kwame-y/BinaryClock/Hardware/3dmodels/B3U-3000P--3DModel-STEP-56544.STEP

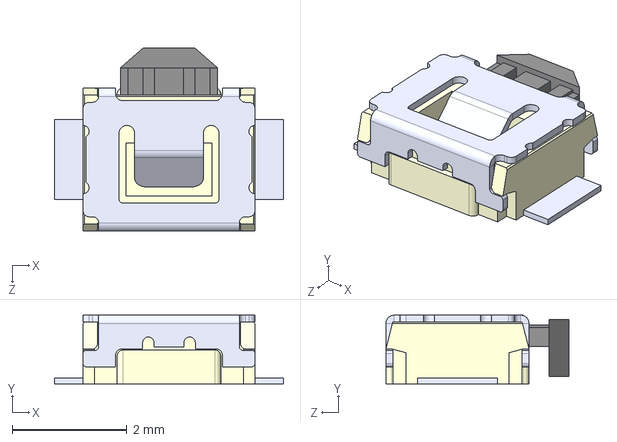
[picture p3: CAD file, 2026-10-17]
Hardware/3dmodels/B3U-3000P--3DModel-STEP-56544.STEP
4.00 x 1.20 x 3.20 mm
