kwame-y/BinaryClock/Hardware/3dmodels/IS31FL3239-QFLS4-TR.stp

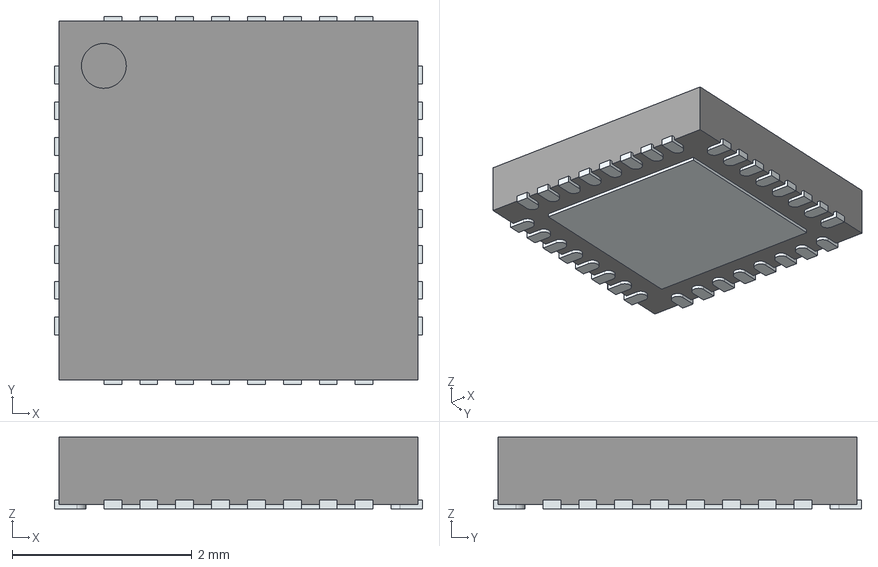
[picture p4: CAD file, 2026-10-17]
Hardware/3dmodels/IS31FL3239-QFLS4-TR.stp
4.10 x 4.10 x 0.8 mm
ThermalPin
PinsArrayLR
PinsArrayTB
