kwame-y/BinaryClock/Hardware/3dmodels/USB4105-GF-A.step

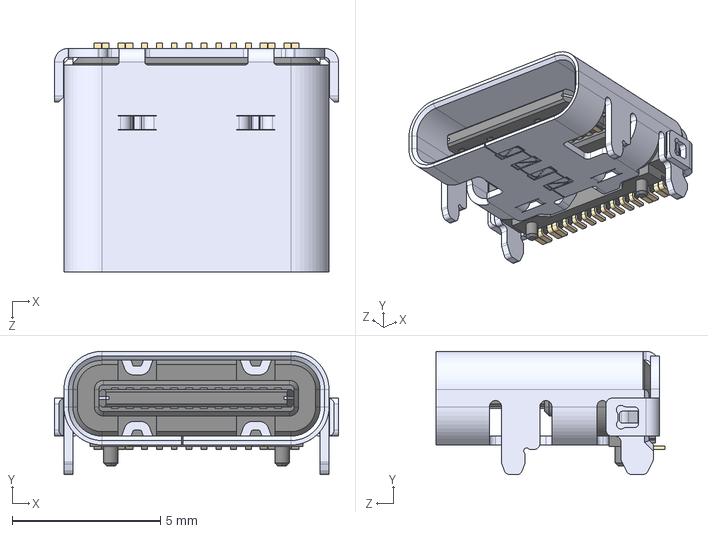
[picture p5: CAD file, 2026-10-17]
Hardware/3dmodels/USB4105-GF-A.step
9.58 x 4.16 x 7.71 mm
