kwame-y/BinaryClock/Hardware/3dmodels/APT1608.STEP

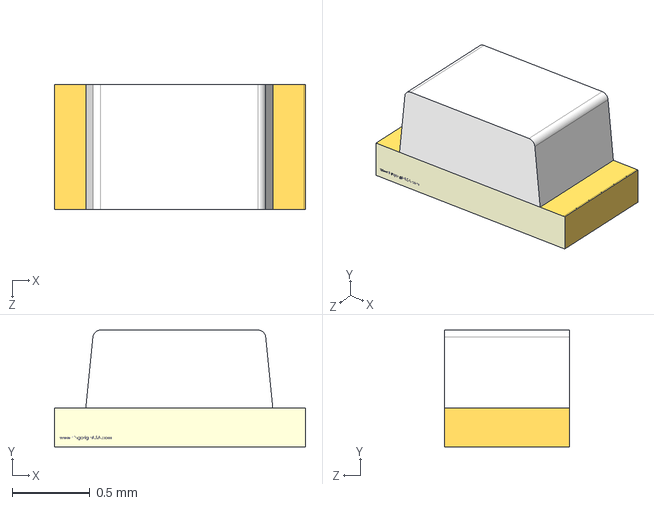
[picture p6: CAD file, 2026-10-17]
Hardware/3dmodels/APT1608.STEP
1.61 x 0.75 x 0.8 mm
