kwame-y/BinaryClock/Hardware/BinaryClock3.kicad_pcb

## KiCad design Hardware/BinaryClock3.kicad_pcb (2026-10-17)

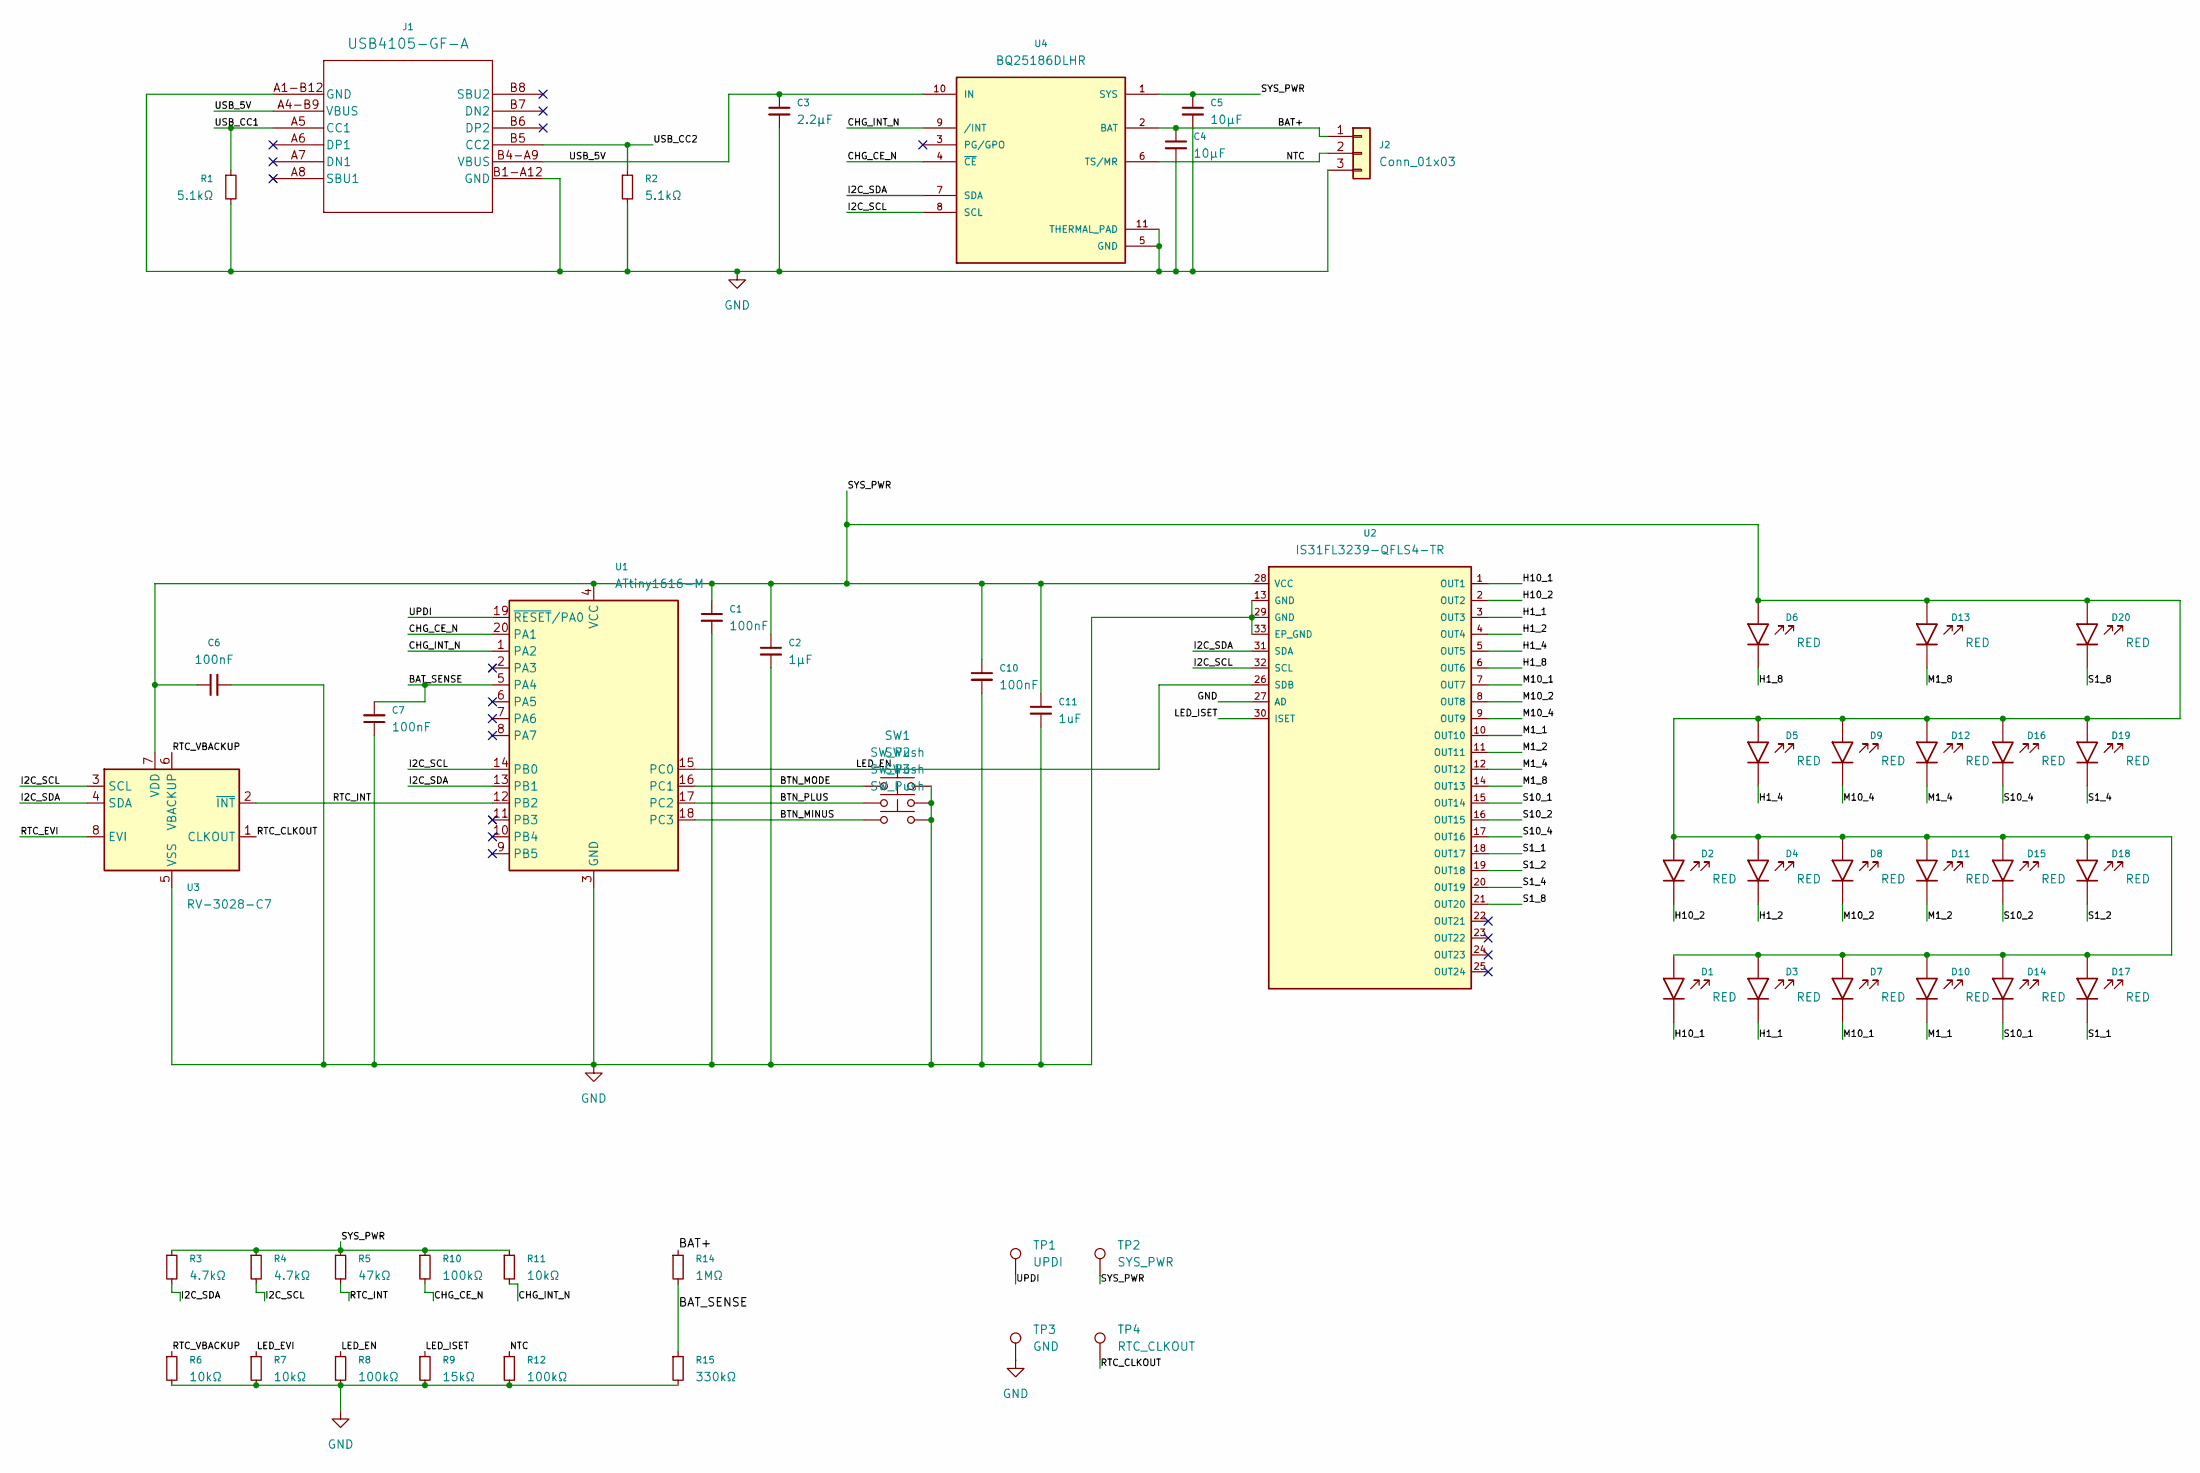
[picture p7: schematic BinaryClock3.kicad_sch]

Parts:
C1, C6, C7, C10: 100nF; C_0402_1005Metric
C2: 1µF; C_0603_1608Metric
C3: 2.2µF; C_0603_1608Metric
C4, C5: 10µF; C_0805_2012Metric
C11: 1uF; C_0201_0603Metric
D1, D2, D3, D4, D5, D6, D7, D8, D9, D10, D11, D12, D13, D14, D15, D16, D17, D18, D19, D20: RED; LED_APT1608LSECK_J3-PRV; MPN APT1608LSECK/J3-PRV
J1: USB4105-GF-A; USB4105_GCT
J2: Conn_01x03; JST_SH_SM03B-SRSS-TB_1x03-1MP_P1.00mm_Horizontal
R1, R2: 5.1kΩ; R_0402_1005Metric
R3, R4: 4.7kΩ; R_0402_1005Metric
R5: 47kΩ; R_0402_1005Metric
R6, R7, R11: 10kΩ; R_0402_1005Metric
R8, R10, R12: 100kΩ; R_0402_1005Metric
R9: 15kΩ; R_0402_1005Metric
R14: 1MΩ; R_0402_1005Metric
R15: 330kΩ; R_0402_1005Metric
SW1, SW2, SW3: SW_Push; SW_B3U-3000P
TP1: UPDI; TestPoint_Pad_1.0x1.0mm
TP2: SYS_PWR; TestPoint_Pad_1.0x1.0mm
TP3: GND; TestPoint_Pad_1.0x1.0mm
TP4: RTC_CLKOUT; TestPoint_Pad_1.0x1.0mm
U1: ATtiny1616-M; VQFN-20-1EP_3x3mm_P0.4mm_EP1.7x1.7mm
U2: IS31FL3239-QFLS4-TR; QFN40P400X400X80-33N-D; MPN IS31FL3239-QFLS4-TR
U3: RV-3028-C7; MicroCrystal_C7_SON-8_1.5x3.2mm_P0.9mm
U4: BQ25186DLHR; IC_BQ25185DLHR; PARTREV OCTOBER 2023

Connections:
/BAT+: C4.1, J2.1, R14.1, U4.2 (BAT)
/BAT_SENSE: C7.2, R14.2, R15.1, U1.5 (PA4)
/BTN_MINUS: SW3.1, U1.18 (PC3)
/BTN_MODE: SW1.1, U1.16 (PC1)
/BTN_PLUS: SW2.1, U1.17 (PC2)
/CHG_CE_N: R10.2, U1.20 (PA1), U4.4 (~CE)
/CHG_INT_N: R11.2, U1.1 (PA2), U4.9 (/INT)
/H1_1: D3.1 (K), U2.3 (OUT3)
/H1_2: D4.1 (K), U2.4 (OUT4)
/H1_4: D5.1 (K), U2.5 (OUT5)
/H1_8: D6.1 (K), U2.6 (OUT6)
/H10_1: D1.1 (K), U2.1 (OUT1)
/H10_2: D2.1 (K), U2.2 (OUT2)
/I2C_SCL: R4.2, U1.14 (PB0), U2.32 (SCL), U3.3 (SCL), U4.8 (SCL)
/I2C_SDA: R3.2, U1.13 (PB1), U2.31 (SDA), U3.4 (SDA), U4.7 (SDA)
/LED_EN: R8.1, U1.15 (PC0), U2.26 (SDB)
/LED_EVI: R7.1
/LED_ISET: R9.1, U2.30 (ISET)
/M1_1: D10.1 (K), U2.10 (OUT10)
/M1_2: D11.1 (K), U2.11 (OUT11)
/M1_4: D12.1 (K), U2.12 (OUT12)
/M1_8: D13.1 (K), U2.14 (OUT13)
/M10_1: D7.1 (K), U2.7 (OUT7)
/M10_2: D8.1 (K), U2.8 (OUT8)
/M10_4: D9.1 (K), U2.9 (OUT9)
/NTC: J2.2, R12.1, U4.6 (TS/MR)
/RTC_CLKOUT: TP4.1 (1_1), U3.1 (CLKOUT)
/RTC_EVI: U3.8 (EVI)
/RTC_INT: R5.2, U1.12 (PB2), U3.2 (~INT)
/RTC_VBACKUP: R6.1, U3.6 (VBACKUP)
/S1_1: D17.1 (K), U2.18 (OUT17)
/S1_2: D18.1 (K), U2.19 (OUT18)
/S1_4: D19.1 (K), U2.20 (OUT19)
/S1_8: D20.1 (K), U2.21 (OUT20)
/S10_1: D14.1 (K), U2.15 (OUT14)
/S10_2: D15.1 (K), U2.16 (OUT15)
/S10_4: D16.1 (K), U2.17 (OUT16)
/SYS_PWR: C1.1, C2.1, C5.1, C6.1, C10.1, C11.1, D1.2 (A), D2.2 (A), D3.2 (A), D4.2 (A), D5.2 (A), D6.2 (A), D7.2 (A), D8.2 (A), D9.2 (A), D10.2 (A), D11.2 (A), D12.2 (A), D13.2 (A), D14.2 (A), D15.2 (A), D16.2 (A), D17.2 (A), D18.2 (A), D19.2 (A), D20.2 (A), R3.1, R4.1, R5.1, R10.1, R11.1, TP2.1 (1_1), U1.4 (VCC), U2.28 (VCC), U3.7 (VDD), U4.1 (SYS)
/UPDI: TP1.1 (1_1), U1.19 (~RESET/PA0)
/USB_5V: C3.1, J1.A4-B9 (VBUS), J1.B4-A9 (VBUS), U4.10 (IN)
/USB_CC1: J1.A5 (CC1), R1.1
/USB_CC2: J1.B5 (CC2), R2.1
GND: C1.2, C2.2, C3.2, C4.2, C5.2, C6.2, C7.1, C10.2, C11.2, J1.A1-B12 (GND), J1.B1-A12 (GND), J2.3, R1.2, R2.2, R6.2, R7.2, R8.2, R9.2, R12.2, R15.2, SW1.2, SW2.2, SW3.2, TP3.1 (1_1), U1.3 (GND), U1.21 (GND), U2.13 (GND), U2.27 (AD), U2.29 (GND), U2.33 (EP_GND), U3.5 (VSS), U4.5 (GND), U4.11 (THERMAL_PAD)

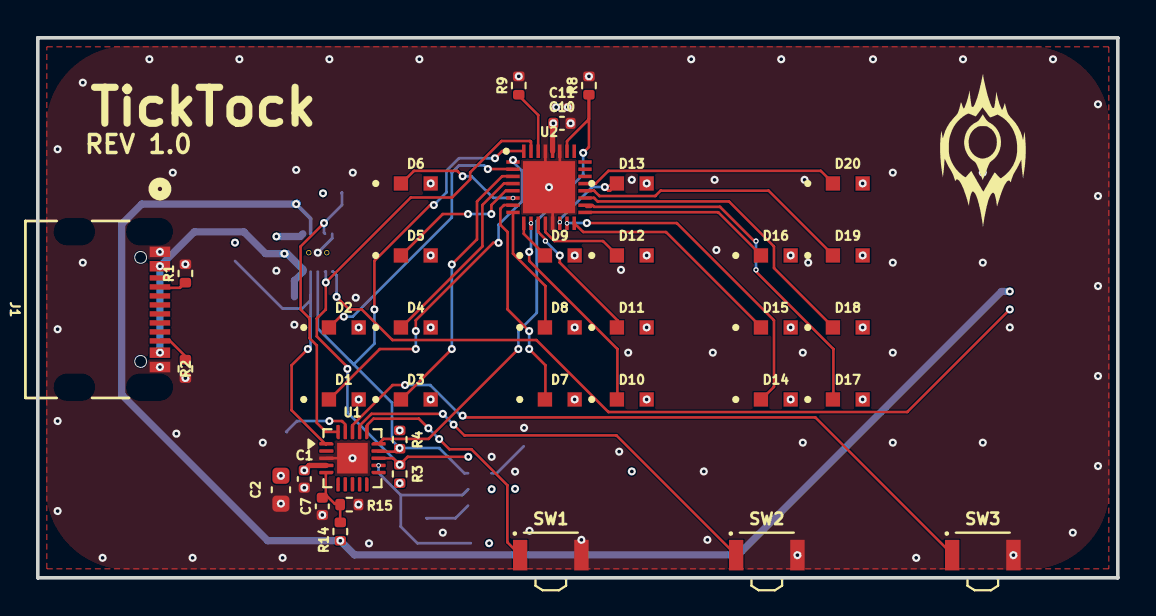
[picture p8: board BinaryClock3.kicad_pcb from above]

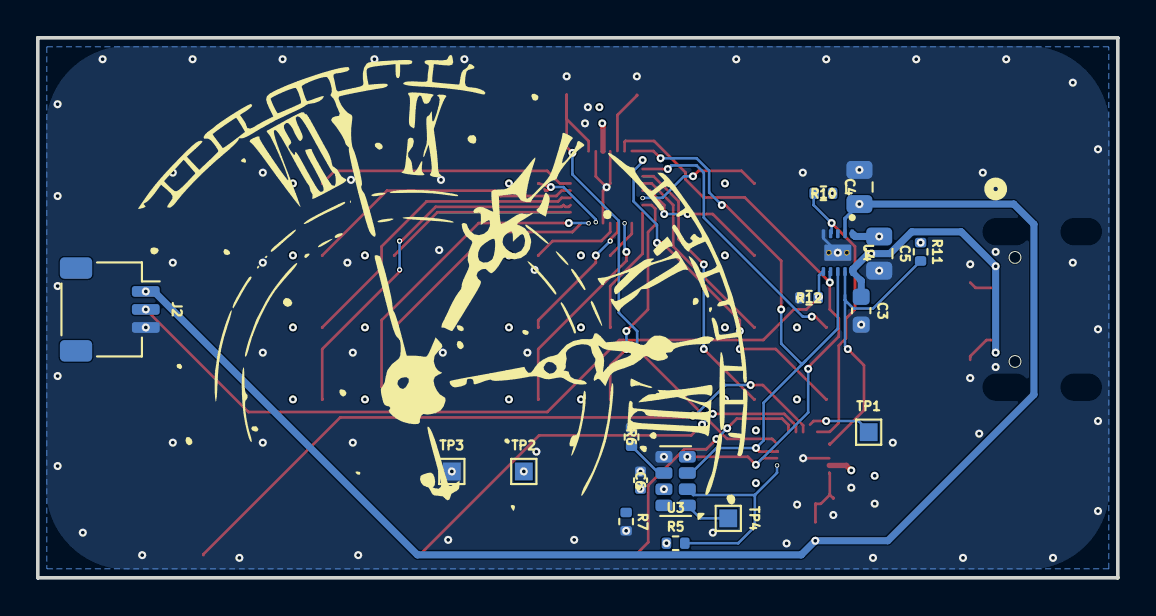
[picture p9: board BinaryClock3.kicad_pcb from below]

Board: 4 copper layers, 60.0 x 30.0 mm, 56 parts (17 on the bottom side), 41 nets.
